svofski/fannyadams/kicad/synth.kicad_pcb

## KiCad design kicad/synth.kicad_pcb (2016-01-24)

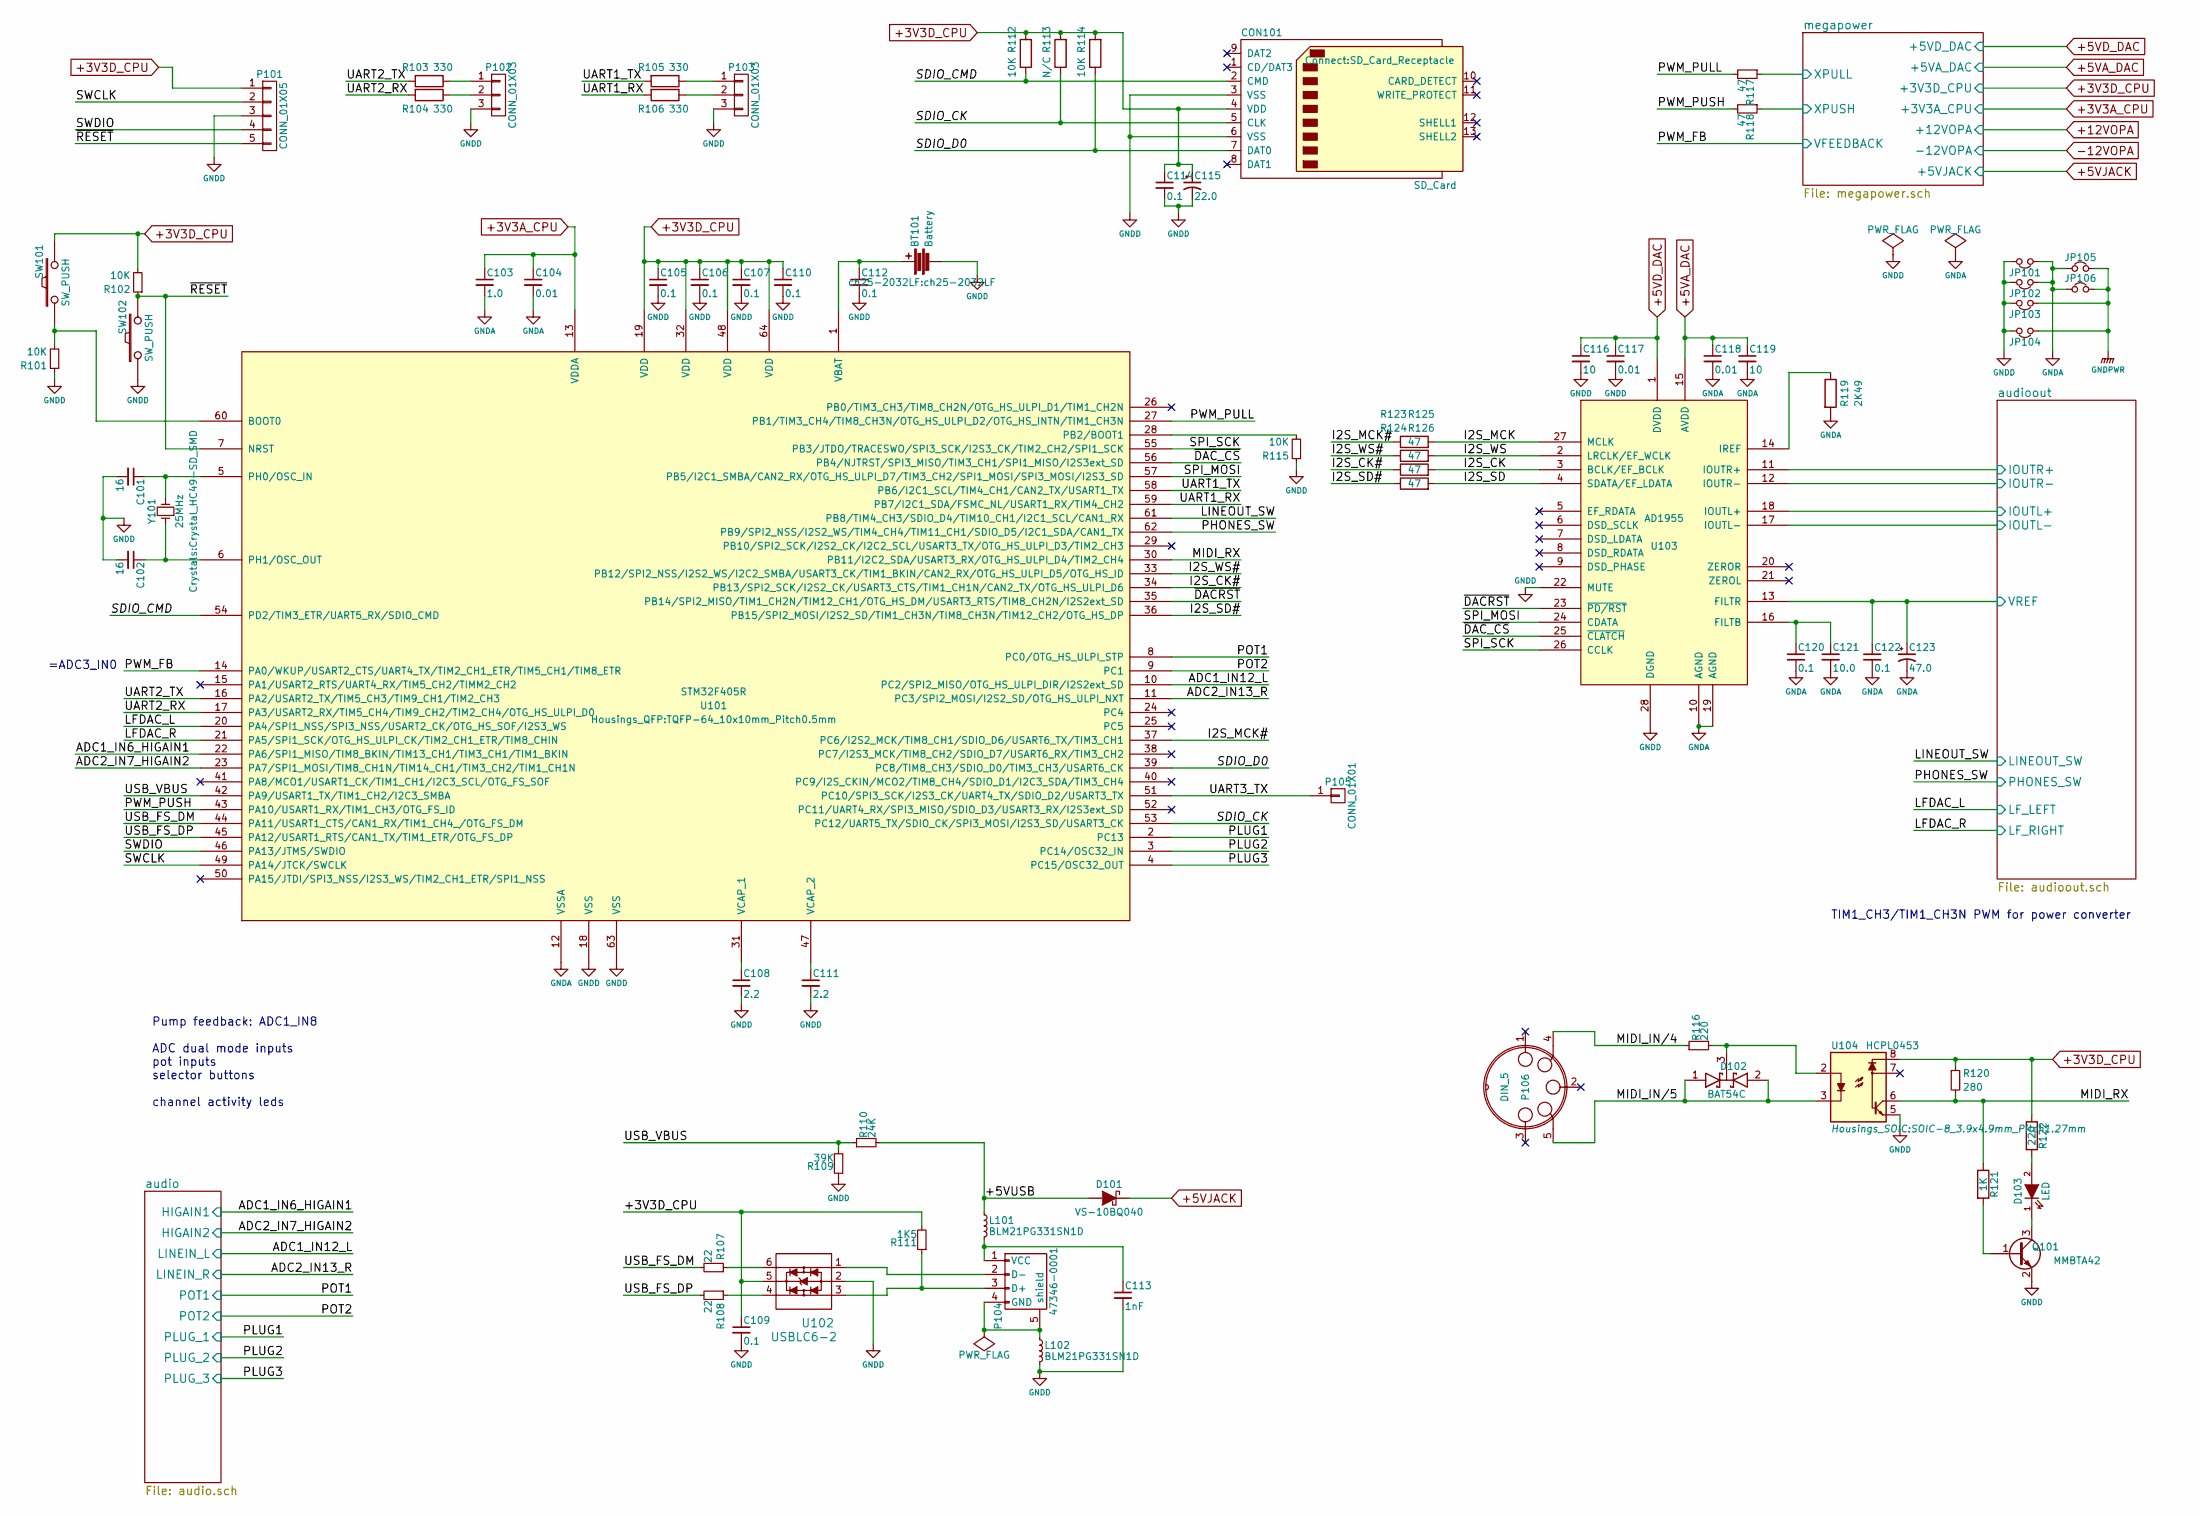
[picture p1: schematic synth.sch]

Parts:
BT101: Battery; ch25-2032LF
C101, C102: 16; C_0805
C103: 1.0; C_0805
C104, C117, C118: 0.01; C_0805
C105, C106, C107, C110, C112, C114, C120, C122: 0.1; C_0603
C108, C111: 2.2; C_0805
C109: 0.1; C_0805
C113: 1nF; C_0805
C115: 22.0; TantalC_SizeD_EIA-7343_Reflow
C116, C119: 10; C_0805
C121: 10.0; C_0805
C123: 47.0; c_elec_5x5.3
CON101: SD_Card; SD_Card_Receptacle
D101: VS-10BQ040; SMB_Standard
D102: BAT54C; SOT-23
D103: LED; LED-0805
JP101, JP102, JP103, JP104, JP105, JP106: Jumper_NC_Small; R_0603
L101, L102: BLM21PG331SN1D; R_0805
P101: CONN_01X05; Pin_Header_Straight_1x05
P102, P103: CONN_01X03; Pin_Header_Straight_1x03
P104: 47346-0001; USB_Micro-B
P105: CONN_01X01; 1Pin
P106: DIN_5; din-5
Q101: MMBTA42; SOT-23
R101, R102, R112, R114, R115: 10K; R_0805
R103, R104, R105, R106: 330; R_0805
R107, R108: 22; R_0805
R109: 39K; R_0805
R110: 24K; R_0805
R111: 1K5; R_0805
R113: N/C; R_0805
R116, R122: 220; R_0805
R117, R118, R123, R124, R125, R126: 47; R_0402
R119: 2K49; R_0805
R120: 280; R_0805
R121: 1K; R_0805
SW101, SW102: SW_PUSH; SW_PUSH_SMALL
U101: STM32F405R; TQFP-64_10x10mm_Pitch0.5mm
U102: USBLC6-2; SOT-23-6
U103: AD1955; SSOP-28_5.3x10.2mm_Pitch0.65mm
U104: HCPL0453; SOIC-8_3.9x4.9mm_Pitch1.27mm
Y101: 25MHz; Crystal_HC49-SD_SMD

Connections:
+3V3A_CPU: C103.1, C104.1, U101.13 (VDDA); also elsewhere on the board
+3V3D_CPU: C105.1, C106.1, C107.1, C109.1, C110.1, C114.1, C115.1, CON101.4 (VDD), P101.1, R102.2, R111.2, R112.2, R113.2, R114.2, R120.1, R122.1, SW101.2, U101.19 (VDD), U101.32 (VDD), U101.48 (VDD), U101.64 (VDD), U102.5, U104.8; also elsewhere on the board
+5VA_DAC: C118.1, C119.1, U103.15 (AVDD); also elsewhere on the board
+5VD_DAC: C116.1, C117.1, U103.1 (DVDD); also elsewhere on the board
+5VJACK: D101.1 (K); also elsewhere on the board
/+5VUSB: D101.2 (A), L101.1, R110.2
/I2S_CK: R125.2, U103.3 (BCLK/EF_BCLK)
/I2S_CK#: R125.1, U101.34 (PB13/SPI2_SCK/I2S2_CK/USART3_CTS/TIM1_C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)
/I2S_MCK: R123.2, U103.27 (MCLK)
/I2S_MCK#: R123.1, U101.37 (PC6/I2S2_MCK/TIM8_CH1/SDIO_D6/USART6_TX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)
/I2S_SD: R126.2, U103.4 (SDATA/EF_LDATA)
/I2S_SD#: R126.1, U101.36 (PB15/SPI2_MOSI/I2S2_SD/TIM1_CH3N/TIM8_C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)
/I2S_WS: R124.2, U103.2 (LRCLK/EF_WCLK)
/I2S_WS#: R124.1, U101.33 (PB12/SPI2_NSS/I2S2_WS/I2C2_SMBA/USART3_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)
/MIDI_IN/4: P106.4, R116.1
/MIDI_IN/5: D102.1 (A), D102.2 (A), P106.5, U104.3
/MIDI_RX: R120.2, R121.1, U101.30 (PB11/I2C2_SDA/USART3_RX/OTG_HS_ULPI_D4/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), U104.6
/PWM_PULL: R117.2, U101.27 (PB1/TIM3_CH4/TIM8_CH3N/OTG_HS_ULPI_D2/O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)
/PWM_PUSH: R118.2, U101.43 (PA10/USART1_RX/TIM1_CH3/OTG_FS_ID)
/SDIO_CK: CON101.5 (CLK), R113.1, U101.53 (PC12/UART5_TX/SDIO_CK/SPI3_MOSI/I2S3_SD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)
/SDIO_CMD: CON101.2 (CMD), R112.1, U101.54 (PD2/TIM3_ETR/UART5_RX/SDIO_CMD)
/SDIO_D0: CON101.7 (DAT0), R114.1, U101.39 (PC8/TIM8_CH3/SDIO_D0/TIM3_CH3/USART6_CK)
/SPI_MOSI: U101.57 (PB5/I2C1_SMBA/CAN2_RX/OTG_HS_ULPI_D7/TI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), U103.24 (CDATA)
/SPI_SCK: U101.55 (PB3/JTDO/TRACESWO/SPI3_SCK/I2S3_CK/TIM2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), U103.26 (CCLK)
/SWCLK: P101.2, U101.49 (PA14/JTCK/SWCLK)
/SWDIO: P101.4, U101.46 (PA13/JTMS/SWDIO)
/UART1_RX: R106.2, U101.59 (PB7/I2C1_SDA/FSMC_NL/USART1_RX/TIM4_CH2)
/UART1_TX: R105.2, U101.58 (PB6/I2C1_SCL/TIM4_CH1/CAN2_TX/USART1_TX)
/UART2_RX: R104.2, U101.17 (PA3/USART2_RX/TIM5_CH4/TIM9_CH2/TIM2_CH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)
/UART2_TX: R103.2, U101.16 (PA2/USART2_TX/TIM5_CH3/TIM9_CH1/TIM2_CH3)
/UART3_TX: P105.1, U101.51 (PC10/SPI3_SCK/I2S3_CK/UART4_TX/SDIO_D2/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)
/USB_FS_DM: R107.2, U101.44 (PA11/USART1_CTS/CAN1_RX/TIM1_CH4_/OTG_F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)
/USB_FS_DP: R108.2, U101.45 (PA12/USART1_RTS/CAN1_TX/TIM1_ETR/OTG_FS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)
/USB_VBUS: R109.2, R110.1, U101.42 (PA9/USART1_TX/TIM1_CH2/I2C3_SMBA)
/audio/HIGAIN1: U101.22 (PA6/SPI1_MISO/TIM8_BKIN/TIM13_CH1/TIM3_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); also elsewhere on the board
/audio/HIGAIN2: U101.23 (PA7/SPI1_MOSI/TIM8_CH1N/TIM14_CH1/TIM3_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); also elsewhere on the board
/audio/LINEIN_L: U101.10 (PC2/SPI2_MISO/OTG_HS_ULPI_DIR/I2S2ext_SD); also elsewhere on the board
/audio/LINEIN_R: U101.11 (PC3/SPI2_MOSI/I2S2_SD/OTG_HS_ULPI_NXT); also elsewhere on the board
/audio/PLUG_1: U101.2 (PC13); also elsewhere on the board
/audio/PLUG_2: U101.3 (PC14/OSC32_IN); also elsewhere on the board
/audio/PLUG_3: U101.4 (PC15/OSC32_OUT); also elsewhere on the board
/audio/POT1: U101.8 (PC0/OTG_HS_ULPI_STP); also elsewhere on the board
/audio/POT2: U101.9 (PC1); also elsewhere on the board
/audioout/IOUTL+: U103.18 (IOUTL+); also elsewhere on the board
/audioout/IOUTL-: U103.17 (IOUTL-); also elsewhere on the board
/audioout/IOUTR+: U103.11 (IOUTR+); also elsewhere on the board
/audioout/IOUTR-: U103.12 (IOUTR-); also elsewhere on the board
/audioout/LF_LEFT: U101.20 (PA4/SPI1_NSS/SPI3_NSS/USART2_CK/OTG_HS_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); also elsewhere on the board
/audioout/LF_RIGHT: U101.21 (PA5/SPI1_SCK/OTG_HS_ULPI_CK/TIM2_CH1_ET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); also elsewhere on the board
/audioout/LINEOUT_SW: U101.61 (PB8/TIM4_CH3/SDIO_D4/TIM10_CH1/I2C1_SCL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); also elsewhere on the board
/audioout/PHONES_SW: U101.62 (PB9/SPI2_NSS/I2S2_WS/TIM4_CH4/TIM11_CH1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); also elsewhere on the board
/audioout/VREF: C122.1, C123.1, U103.13 (FILTR); also elsewhere on the board
/megapower/VFEEDBACK: U101.14 (PA0/WKUP/USART2_CTS/UART4_TX/TIM2_CH1_E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); also elsewhere on the board
/megapower/XPULL: R117.1; also elsewhere on the board
/megapower/XPUSH: R118.1; also elsewhere on the board
/~DACRST: U101.35 (PB14/SPI2_MISO/TIM1_CH2N/TIM12_CH1/OTG_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), U103.23 (~PD/RST)
/~DAC_CS: U101.56 (PB4/NJTRST/SPI3_MISO/TIM3_CH1/SPI1_MISO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), U103.25 (~CLATCH)
/~RESET: P101.5, R102.1, SW102.2, U101.7 (NRST)
GNDA: C103.2, C104.2, C118.2, C119.2, C120.2, C121.2, C122.2, C123.2, JP101.1, JP102.1, JP105.1, JP106.1, R119.2, U101.12 (VSSA), U103.10 (AGND), U103.19 (AGND); also elsewhere on the board
GNDD: BT101.2, C101.2, C102.2, C105.2, C106.2, C107.2, C108.2, C109.2, C110.2, C111.2, C112.2, C113.2, C114.2, C115.2, C116.2, C117.2, CON101.3 (VSS), CON101.6 (VSS), JP101.2, JP102.2, JP103.2, JP104.2, L102.2, P101.3, P102.3, P103.3, Q101.2 (E), R101.1, R109.1, R115.1, SW102.1, U101.18 (VSS), U101.63 (VSS), U102.2, U103.22 (MUTE), U103.28 (DGND), U104.5; also elsewhere on the board
GNDPWR: JP103.1, JP104.1, JP105.2, JP106.2; also elsewhere on the board
unnamed: BT101.1, C112.1, U101.1 (VBAT)
unnamed: C101.1, U101.5 (PH0/OSC_IN), Y101.2
unnamed: C102.1, U101.6 (PH1/OSC_OUT), Y101.1
unnamed: C108.1, U101.31 (VCAP_1)
unnamed: C111.1, U101.47 (VCAP_2)
unnamed: C113.1, L101.2, P104.1 (VCC)
unnamed: C120.1, C121.1, U103.16 (FILTB)
unnamed: D102.3 (K), R116.2, U104.2
unnamed: D103.1 (K), Q101.3 (C)
unnamed: D103.2 (A), R122.2
unnamed: L102.1, P104.4 (GND), P104.5 (shield)
unnamed: P102.1, R103.1
unnamed: P102.2, R104.1
unnamed: P103.1, R105.1
unnamed: P103.2, R106.1
unnamed: P104.2 (D-), U102.1
unnamed: P104.3 (D+), R111.1, U102.3
unnamed: Q101.1 (B), R121.2
unnamed: R101.2, SW101.1, U101.60 (BOOT0)
unnamed: R107.1, U102.6
unnamed: R108.1, U102.4
unnamed: R115.2, U101.28 (PB2/BOOT1)
unnamed: R119.1, U103.14 (IREF)

Notes on the sheet:
TIM1_CH3/TIM1_CH3N PWM for power converter
Pump feedback: ADC1_IN8 ADC dual mode inputs pot inputs selector buttons channel activity leds
=ADC3_IN0

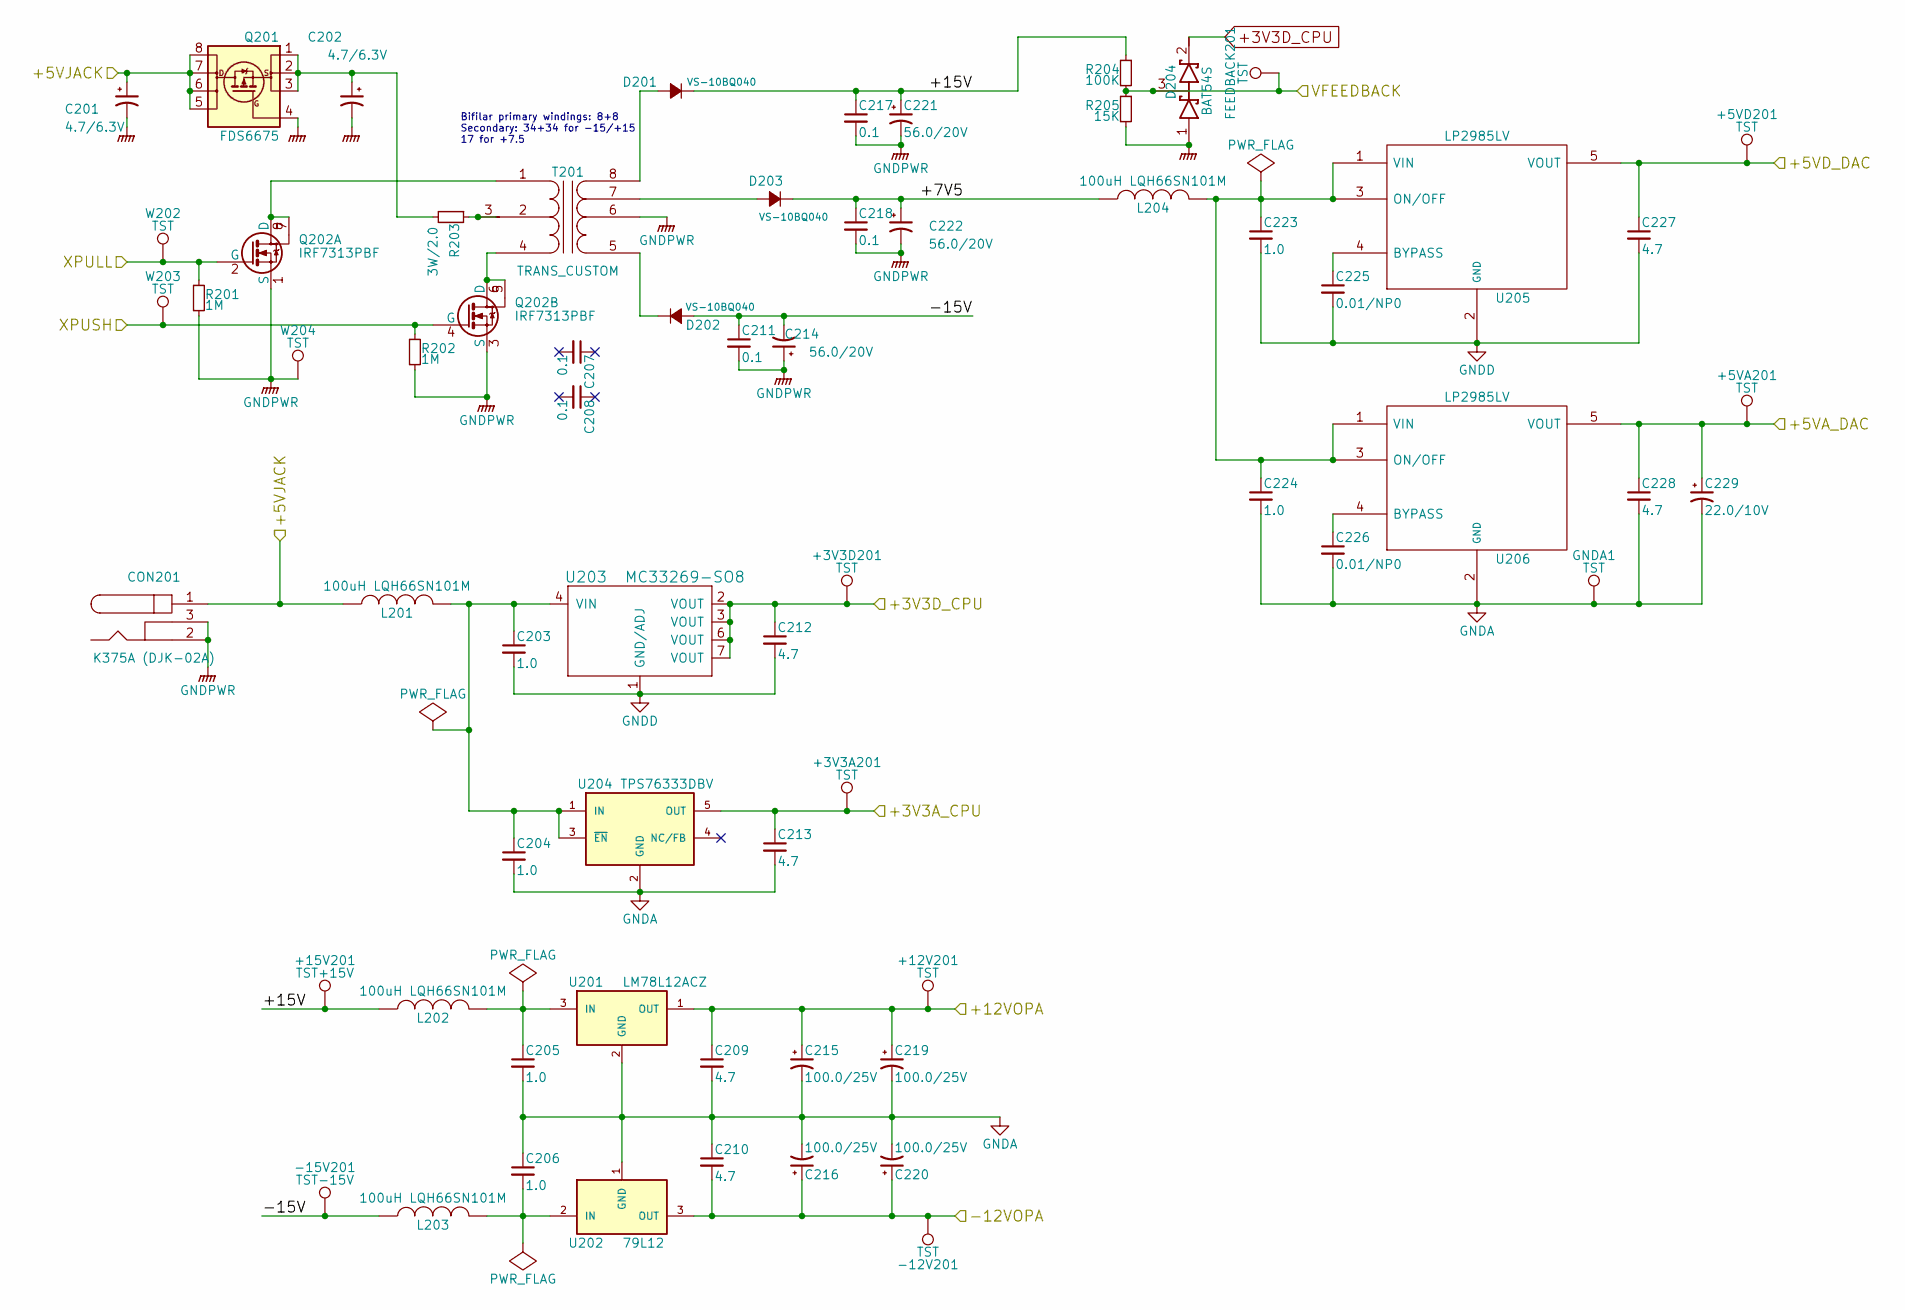
[picture p2: schematic megapower.sch]

Parts:
+3V3A201, +3V3D201, +5VA201, +5VD201, +12V201: TST; PINTST
+15V201: TST+15V; PINTST
-12V201: TST; PINTST
-15V201: TST-15V; PINTST
C201, C202: 4.7/6.3V; c_elec_5x5.3
C203, C204, C205, C206, C223, C224: 1.0; C_0805
C207, C208, C211: 0.1; C_0805
C209, C210, C212, C213, C227, C228: 4.7; C_0805
C214, C221, C222: 56.0/20V; C_Radial_D6.3_L11.2_P2.5
C215, C216, C219, C220: 100.0/25V; c_elec_6.3x7.7
C217, C218: 0.1; C_0603
C225, C226: 0.01/NP0; C_0805
C229: 22.0/10V; TantalC_SizeC_EIA-6032_Reflow
CON201: K375A (DJK-02A); BARREL_JACK
D201, D202, D203: VS-10BQ040; SMB_Standard
D204: BAT54S; SOT-23
FEEDBACK201: TST; PINTST
GNDA1: TST; PINTST
L201, L202, L203, L204: 100uH LQH66SN101M; Choke_SMD_6.3x6.3_H3
Q201: FDS6675; SOIC-8_3.9x4.9mm_Pitch1.27mm
Q202: IRF7313PBF; SO-8
R201, R202: 1M; R_0805
R203: 3W/2.0; R_0805
R204: 100K; R_0805
R205: 15K; R_0805
T201: TRANS_CUSTOM; Coilcraft-Q4434-B_Rhombus-T1311
U201: LM78L12ACZ; TO-92_Inline_Wide
U202: 79L12; TO-92_Inline_Wide
U203: MC33269-SO8; SOIC-8_3.9x4.9mm_Pitch1.27mm
U204: TPS76333DBV; SOT-23-5
U205, U206: LP2985LV; SOT-23-5
W202, W203, W204: TST; PINTST

Connections:
+3V3A_CPU: +3V3A201.1, C213.1, U204.5 (OUT); also elsewhere on the board
+3V3D_CPU: +3V3D201.1, C212.1, D204.2 (K), U203.2 (VOUT), U203.3 (VOUT), U203.6 (VOUT), U203.7 (VOUT); also elsewhere on the board
+5VA_DAC: +5VA201.1, C228.1, C229.1, U206.5 (VOUT); also elsewhere on the board
+5VD_DAC: +5VD201.1, C227.1, U205.5 (VOUT); also elsewhere on the board
+5VJACK: C201.1, CON201.1, L201.1, Q201.5 (D), Q201.6 (D), Q201.7 (D), Q201.8 (D); also elsewhere on the board
+12VOPA: +12V201.1, C209.1, C215.1, C219.1, U201.1 (OUT); also elsewhere on the board
-12VOPA: -12V201.1, C210.2, C216.1, C220.1, U202.3 (OUT); also elsewhere on the board
/megapower/+7V5: C218.1, C222.1, D203.1 (K), L204.1
/megapower/+15V: +15V201.1, C217.1, C221.1, D201.1 (K), L202.1, R204.1
/megapower/-15V: -15V201.1, C211.1, C214.2, D202.2 (A), L203.1
/megapower/VFEEDBACK: D204.3 (common), FEEDBACK201.1, R204.2, R205.1; also elsewhere on the board
/megapower/XPULL: Q202.2 (G), R201.1, W202.1; also elsewhere on the board
/megapower/XPUSH: Q202.4 (G), R202.1, W203.1; also elsewhere on the board
GNDA: C204.2, C205.2, C206.1, C209.2, C210.1, C213.2, C215.2, C216.2, C219.2, C220.2, C224.2, C226.2, C228.2, C229.2, GNDA1.1, U201.2 (GND), U202.1 (GND), U204.2 (GND), U206.2 (GND); also elsewhere on the board
GNDD: C203.2, C212.2, C223.2, C225.2, C227.2, U203.1 (GND/ADJ), U205.2 (GND); also elsewhere on the board
GNDPWR: C201.2, C202.2, C211.2, C214.1, C217.2, C218.2, C221.2, C222.2, CON201.2, CON201.3, D204.1 (A), Q201.4 (G), Q202.1 (S), Q202.3 (S), R201.2, R202.2, R205.2, T201.6, W204.1; also elsewhere on the board
unnamed: C202.1, Q201.1 (S), Q201.2 (S), Q201.3 (S), R203.2
unnamed: C203.1, C204.1, L201.2, U203.4 (VIN), U204.1 (IN), U204.3 (~EN~)
unnamed: C205.1, L202.2, U201.3 (IN)
unnamed: C206.2, L203.2, U202.2 (IN)
unnamed: C223.1, C224.1, L204.2, U205.1 (VIN), U205.3 (ON/OFF), U206.1 (VIN), U206.3 (ON/OFF)
unnamed: C225.1, U205.4 (BYPASS)
unnamed: C226.1, U206.4 (BYPASS)
unnamed: D201.2 (A), T201.8 (S2)
unnamed: D202.1 (K), T201.5 (S1)
unnamed: D203.2 (A), T201.7
unnamed: Q202.5, Q202.6 (D), T201.4 (PR2)
unnamed: Q202.7, Q202.8 (D), T201.1 (PR1)
unnamed: R203.1, T201.2 (PM), T201.3

Notes on the sheet:
Bifilar primary windings: 8+8 Secondary: 34+34 for -15/+15 17 for +7.5

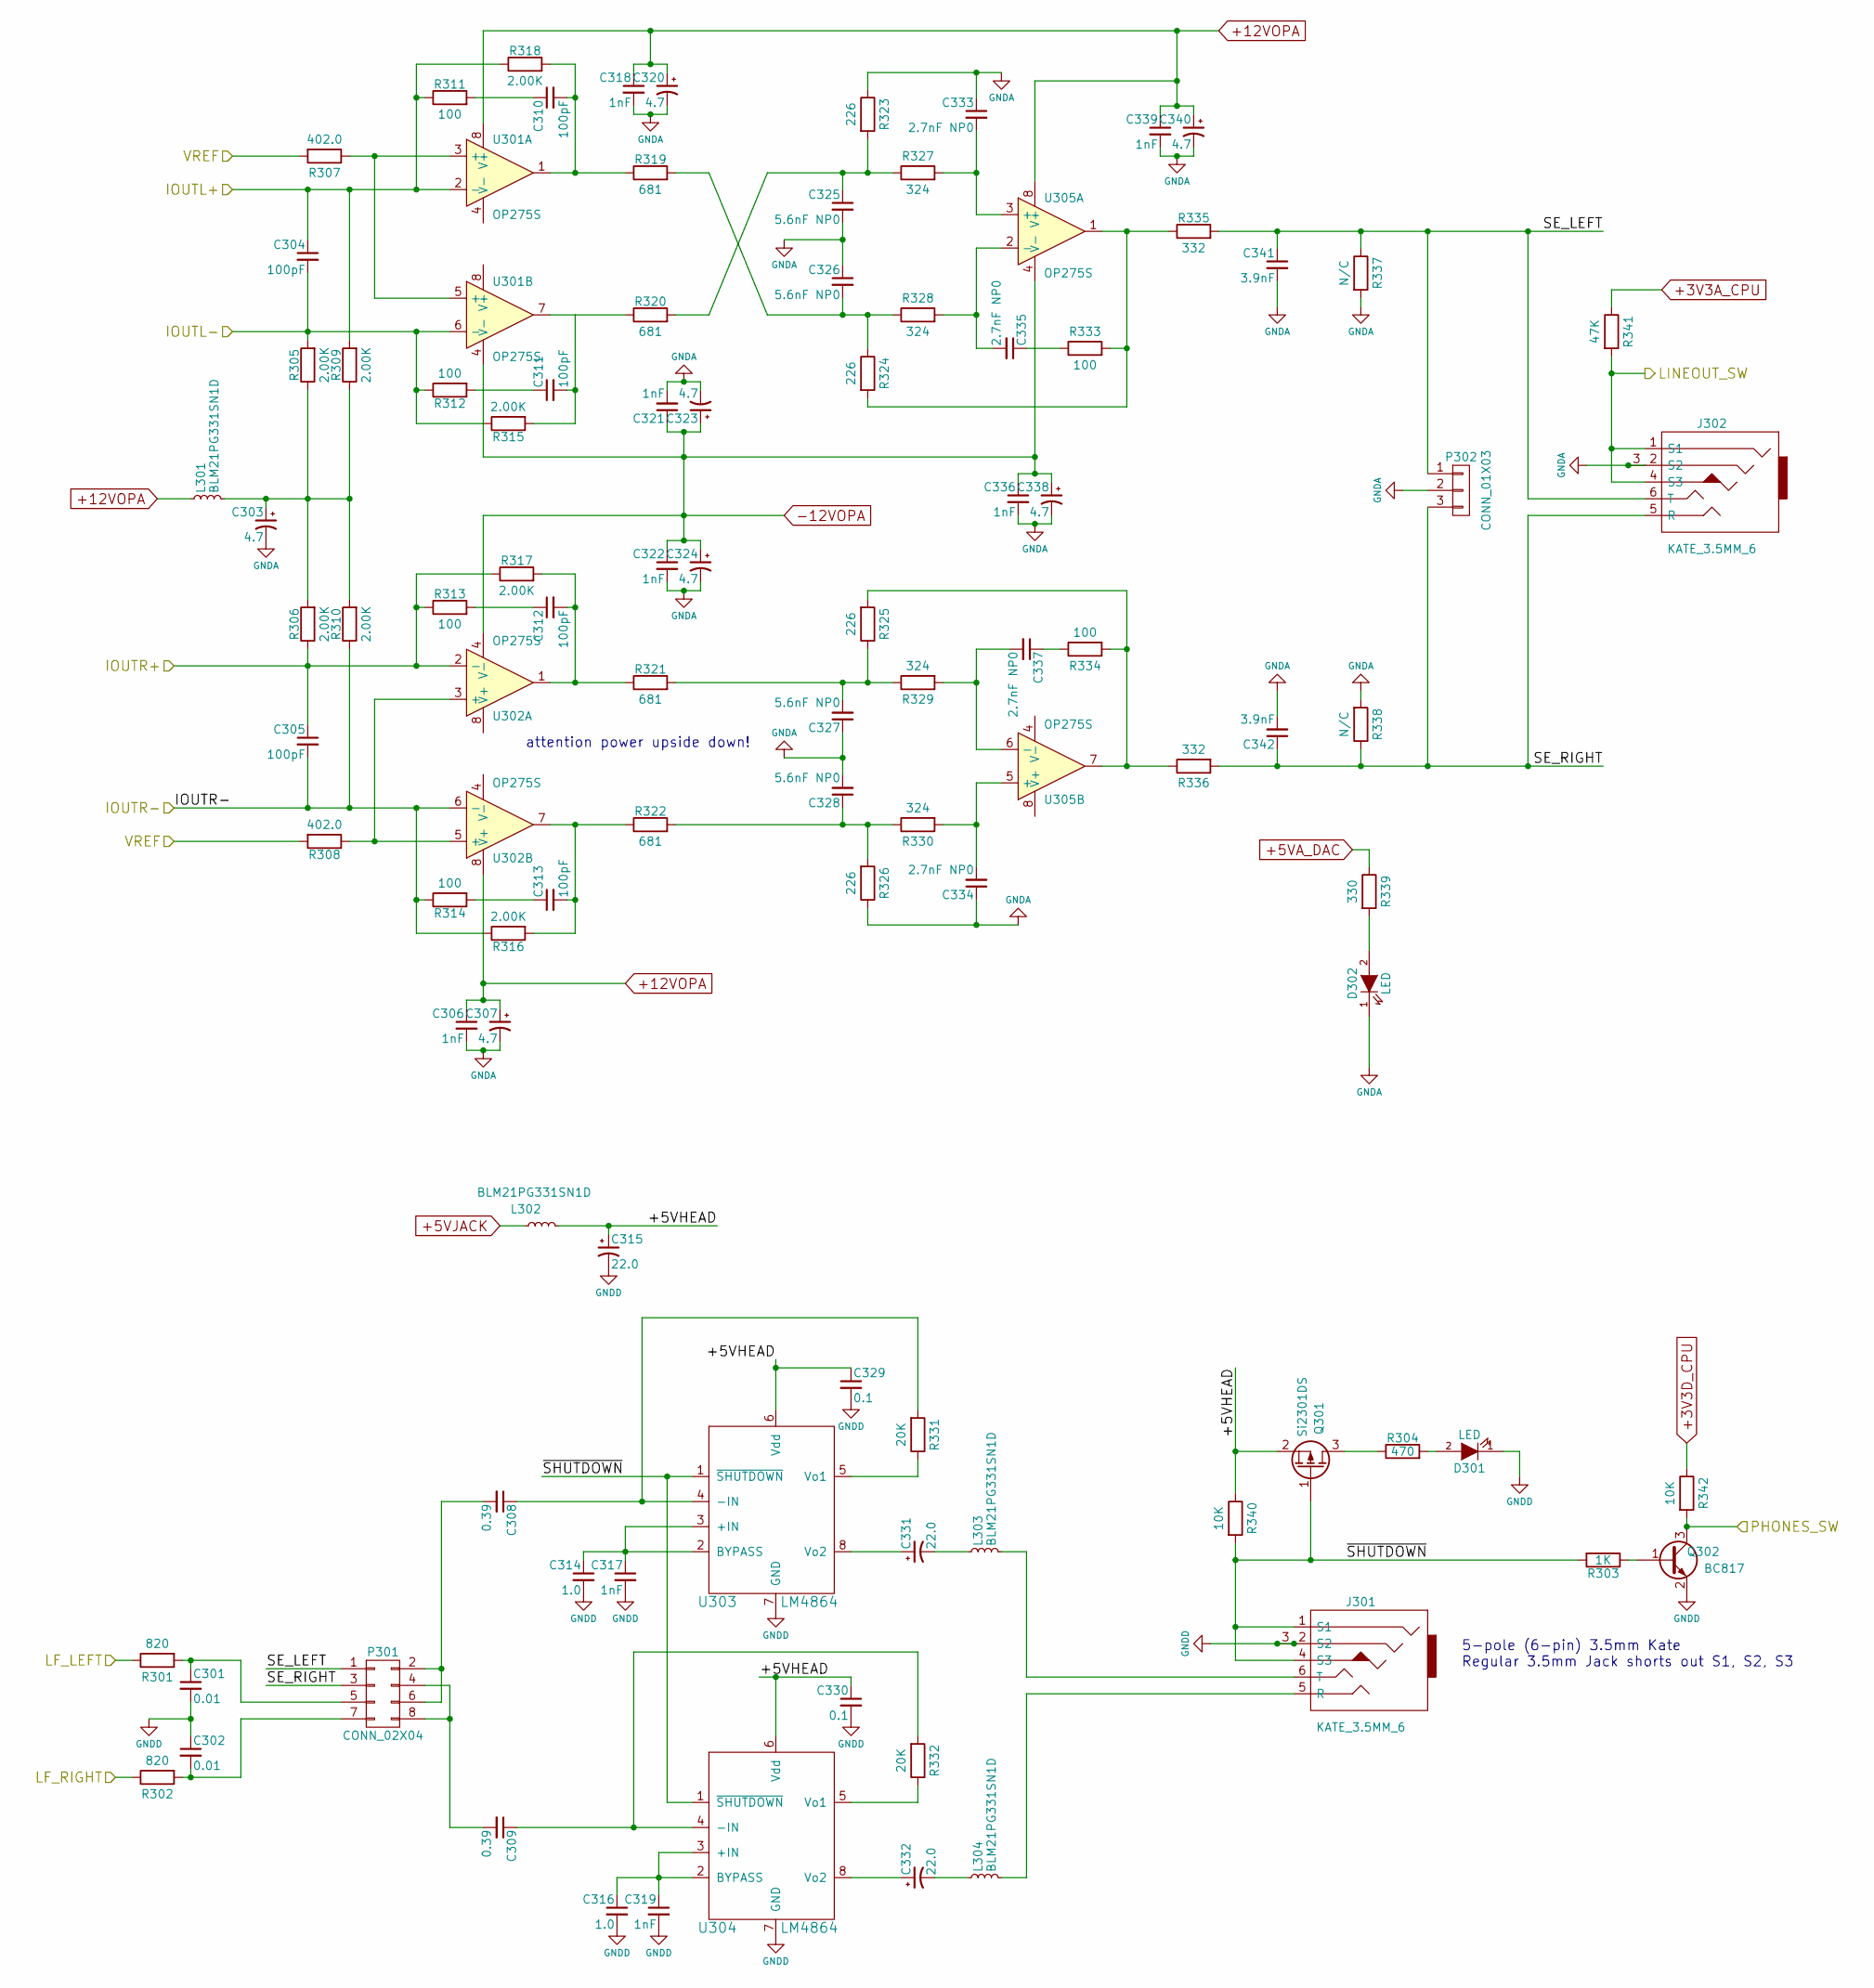
[picture p3: schematic audioout.sch]

Parts:
C301, C302: 0.01; C_0805
C303, C307, C320, C323, C324, C338, C340: 4.7; C_0805
C304, C305, C310, C311, C312, C313: 100pF; C_0805
C306, C317, C318, C319, C321, C322, C336, C339: 1nF; C_0805
C308, C309: 0.39; C_0805
C314, C316: 1.0; C_0805
C315, C331, C332: 22.0; TantalC_SizeC_EIA-6032_Reflow
C325, C326, C327, C328: 5.6nF NP0; C_0805
C329, C330: 0.1; C_0805
C333, C334, C335, C337: 2.7nF NP0; C_0805
C341, C342: 3.9nF; C_0805
D301, D302: LED; LED-0805
J301, J302: KATE_3.5MM_6; JACK_35MM_KATE_6
L301, L302, L303, L304: BLM21PG331SN1D; R_0805
P301: CONN_02X04; Pin_Header_Straight_2x04
P302: CONN_01X03; Pin_Header_Straight_1x03
Q301: Si2301DS; SOT-23
Q302: BC817; SOT-23
R301, R302: 820; R_1206
R303: 1K; R_0805
R304: 470; R_0805
R305, R306, R309, R310, R315, R316, R317, R318: 2.00K; R_0805
R307, R308: 402.0; R_1206
R311, R312, R313, R314, R333, R334: 100; R_0805
R319, R320, R321, R322: 681; R_0805
R323, R324, R325, R326: 226; R_0805
R327, R328, R329, R330: 324; R_0805
R331, R332: 20K; R_0805
R335, R336: 332; R_0805
R337, R338: N/C; R_0805
R339: 330; R_0805
R340, R342: 10K; R_0805
R341: 47K; R_0805
U301, U302, U305: OP275S; SOIC-8_3.9x4.9mm_Pitch1.27mm
U303, U304: LM4864; SOIC-8_3.9x4.9mm_Pitch1.27mm

Connections:
+3V3A_CPU: R341.1; also elsewhere on the board
+3V3D_CPU: R342.1; also elsewhere on the board
+5VA_DAC: R339.1; also elsewhere on the board
+5VJACK: L302.1; also elsewhere on the board
+12VOPA: C306.1, C307.1, C318.1, C320.1, C339.1, C340.1, L301.1, U301.8 (V+), U302.8 (V+), U305.8 (V+); also elsewhere on the board
-12VOPA: C321.1, C322.1, C323.1, C324.1, C336.1, C338.1, U301.4 (V-), U302.4 (V-), U305.4 (V-); also elsewhere on the board
/audioout/+5VHEAD: C315.1, C329.1, C330.1, L302.2, Q301.2 (S), R340.1, U303.6 (Vdd), U304.6 (Vdd)
/audioout/IOUTL+: C304.1, R309.2, R311.1, R318.1, U301.2 (-); also elsewhere on the board
/audioout/IOUTL-: C304.2, R305.2, R312.1, R315.1, U301.6 (-); also elsewhere on the board
/audioout/IOUTR+: C305.1, R306.1, R313.1, R317.1, U302.2 (-); also elsewhere on the board
/audioout/IOUTR-: C305.2, R310.1, R314.1, R316.1, U302.6 (-); also elsewhere on the board
/audioout/LF_LEFT: R301.1; also elsewhere on the board
/audioout/LF_RIGHT: R302.1; also elsewhere on the board
/audioout/LINEOUT_SW: J302.1 (S1), J302.4 (S3), R341.2; also elsewhere on the board
/audioout/PHONES_SW: Q302.3 (C), R342.2; also elsewhere on the board
/audioout/SE_LEFT: C341.1, J302.6 (T), P301.1, P302.1, R335.2, R337.1
/audioout/SE_RIGHT: C342.1, J302.5 (R), P301.3, P302.3, R336.2, R338.1
/audioout/VREF: R307.2, R308.2; also elsewhere on the board
/audioout/~SHUTDOWN: J301.1 (S1), J301.4 (S3), Q301.1 (G), R303.2, R340.2, U303.1 (~SHUTDOWN), U304.1 (~SHUTDOWN)
GNDA: C303.2, C306.2, C307.2, C318.2, C320.2, C321.2, C322.2, C323.2, C324.2, C325.2, C326.1, C327.1, C328.2, C333.1, C334.1, C336.2, C338.2, C339.2, C340.2, C341.2, C342.2, D302.1 (K), J302.2 (S2), J302.3, P302.2, R323.1, R326.1, R337.2, R338.2; also elsewhere on the board
GNDD: C301.2, C302.1, C314.2, C315.2, C316.2, C317.2, C319.2, C329.2, C330.2, D301.1 (K), J301.2 (S2), J301.3, Q302.2 (E), U303.7 (GND), U304.7 (GND); also elsewhere on the board
unnamed: C301.1, P301.5, R301.2
unnamed: C302.2, P301.7, R302.2
unnamed: C303.1, L301.2, R305.1, R306.2, R309.1, R310.2
unnamed: C308.2, P301.2, P301.6
unnamed: C309.2, P301.4, P301.8
unnamed: C310.1, R311.2
unnamed: C310.2, R318.2, R319.1, U301.1
unnamed: C311.1, R312.2
unnamed: C312.1, R313.2
unnamed: C312.2, R317.2, R321.1, U302.1
unnamed: C313.1, R314.2
unnamed: C313.2, R316.2, R322.1, U302.7
unnamed: C314.1, C317.1, U303.2 (BYPASS), U303.3 (+IN)
unnamed: C316.1, C319.1, U304.2 (BYPASS), U304.3 (+IN)
unnamed: C325.1, R320.2, R323.2, R327.1
unnamed: C326.2, R319.2, R324.1, R328.1
unnamed: C327.2, R321.2, R325.1, R329.1
unnamed: C328.1, R322.2, R326.2, R330.1
unnamed: C331.1, U303.8 (Vo2)
unnamed: C331.2, L303.1
unnamed: C332.1, U304.8 (Vo2)
unnamed: C332.2, L304.1
unnamed: C333.2, R327.2, U305.3 (+)
unnamed: C334.2, R330.2, U305.5 (+)
unnamed: C335.1, R333.1
unnamed: C335.2, R328.2, U305.2 (-)
unnamed: C337.1, R334.1
unnamed: C337.2, R329.2, U305.6 (-)
unnamed: D301.2 (A), R304.2
unnamed: D302.2 (A), R339.2
unnamed: J301.5 (R), L304.2
unnamed: J301.6 (T), L303.2
unnamed: Q301.3 (D), R304.1
unnamed: Q302.1 (B), R303.1
unnamed: R307.1, U301.3 (+), U301.5 (+)
unnamed: R308.1, U302.3 (+), U302.5 (+)
unnamed: R324.2, R333.2, R335.1, U305.1
unnamed: R325.2, R334.2, R336.1, U305.7
unnamed: R331.1, U303.5 (Vo1)
unnamed: R332.1, U304.5 (Vo1)

Notes on the sheet:
attention power upside down!
5-pole (6-pin) 3.5mm Kate Regular 3.5mm Jack shorts out S1, S2, S3
