svofski/fannyadams/kicad/synth.kicad_pcb

## KiCad design kicad/synth.kicad_pcb (continued)

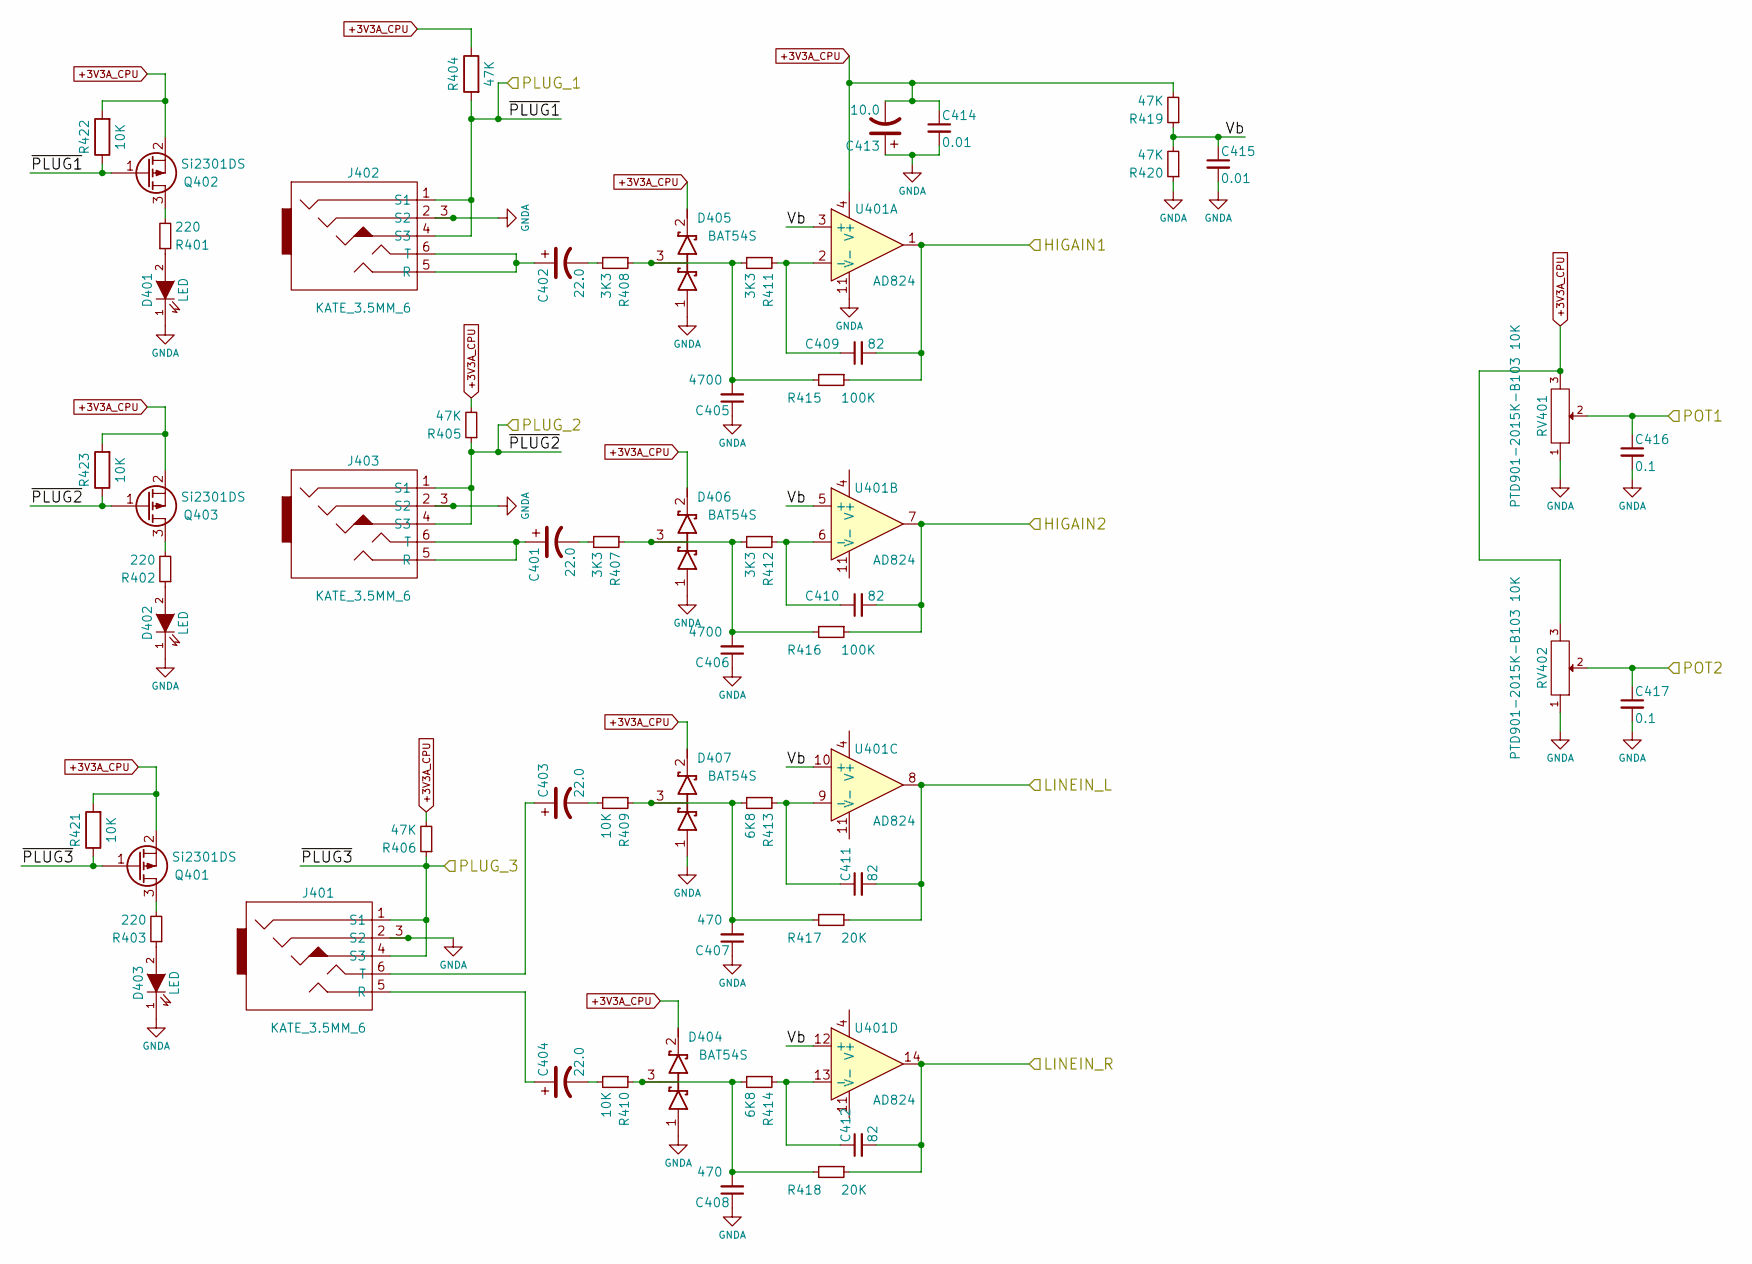
[picture p4: schematic audio.sch]

Parts:
C401, C402, C403, C404: 22.0; TantalC_SizeC_EIA-6032_Reflow
C405, C406: 4700; C_0805
C407, C408: 470; C_0805
C409, C410, C411, C412: 82; C_0805
C413: 10.0; C_0805
C414, C415: 0.01; C_0805
C416, C417: 0.1; C_0805
D401, D402, D403: LED; LED-0805
D404, D405, D406, D407: BAT54S; SOT-23
J401, J402, J403: KATE_3.5MM_6; JACK_35MM_KATE_6
Q401, Q402, Q403: Si2301DS; SOT-23
R401, R402, R403: 220; R_0805
R404, R405, R406, R419, R420: 47K; R_0805
R407, R408, R411, R412: 3K3; R_0805
R409, R410, R421, R422, R423: 10K; R_0805
R413, R414: 6K8; R_0805
R415, R416: 100K; R_0805
R417, R418: 20K; R_0805
RV401, RV402: PTD901-2015K-B103 10K; Potentiometer_Alps-RK16-single_largePads
U401: AD824; SOIC-14_3.9x8.7mm_Pitch1.27mm

Connections:
+3V3A_CPU: C413.2, C414.1, D404.2 (K), D405.2 (K), D406.2 (K), D407.2 (K), Q401.2 (S), Q402.2 (S), Q403.2 (S), R404.1, R405.2, R406.2, R419.2, R421.2, R422.2, R423.2, RV401.3, RV402.3, U401.4 (V+); also elsewhere on the board
/audio/HIGAIN1: C409.2, R415.1, U401.1; also elsewhere on the board
/audio/HIGAIN2: C410.2, R416.1, U401.7; also elsewhere on the board
/audio/LINEIN_L: C411.2, R417.1, U401.8; also elsewhere on the board
/audio/LINEIN_R: C412.2, R418.1, U401.14; also elsewhere on the board
/audio/PLUG_1: J402.1 (S1), J402.4 (S3), Q402.1 (G), R404.2, R422.1; also elsewhere on the board
/audio/PLUG_2: J403.1 (S1), J403.4 (S3), Q403.1 (G), R405.1, R423.1; also elsewhere on the board
/audio/PLUG_3: J401.1 (S1), J401.4 (S3), Q401.1 (G), R406.1, R421.1; also elsewhere on the board
/audio/POT1: C416.1, RV401.2; also elsewhere on the board
/audio/POT2: C417.1, RV402.2; also elsewhere on the board
/audio/Vb: C415.1, R419.1, R420.2, U401.3 (+), U401.5 (+), U401.10 (+), U401.12 (+)
GNDA: C405.1, C406.1, C407.1, C408.1, C413.1, C414.2, C415.2, C416.2, C417.2, D401.1 (K), D402.1 (K), D403.1 (K), D404.1 (A), D405.1 (A), D406.1 (A), D407.1 (A), J401.2 (S2), J401.3, J402.2 (S2), J402.3, J403.2 (S2), J403.3, R420.1, RV401.1, RV402.1, U401.11 (V-); also elsewhere on the board
unnamed: C401.1, J403.5 (R), J403.6 (T)
unnamed: C401.2, R407.2
unnamed: C402.1, J402.5 (R), J402.6 (T)
unnamed: C402.2, R408.2
unnamed: C403.1, J401.6 (T)
unnamed: C403.2, R409.2
unnamed: C404.1, J401.5 (R)
unnamed: C404.2, R410.2
unnamed: C405.2, D405.3 (common), R408.1, R411.2, R415.2
unnamed: C406.2, D406.3 (common), R407.1, R412.2, R416.2
unnamed: C407.2, D407.3 (common), R409.1, R413.2, R417.2
unnamed: C408.2, D404.3 (common), R410.1, R414.2, R418.2
unnamed: C409.1, R411.1, U401.2 (-)
unnamed: C410.1, R412.1, U401.6 (-)
unnamed: C411.1, R413.1, U401.9 (-)
unnamed: C412.1, R414.1, U401.13 (-)
unnamed: D401.2 (A), R401.1
unnamed: D402.2 (A), R402.1
unnamed: D403.2 (A), R403.1
unnamed: Q401.3 (D), R403.2
unnamed: Q402.3 (D), R401.2
unnamed: Q403.3 (D), R402.2

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
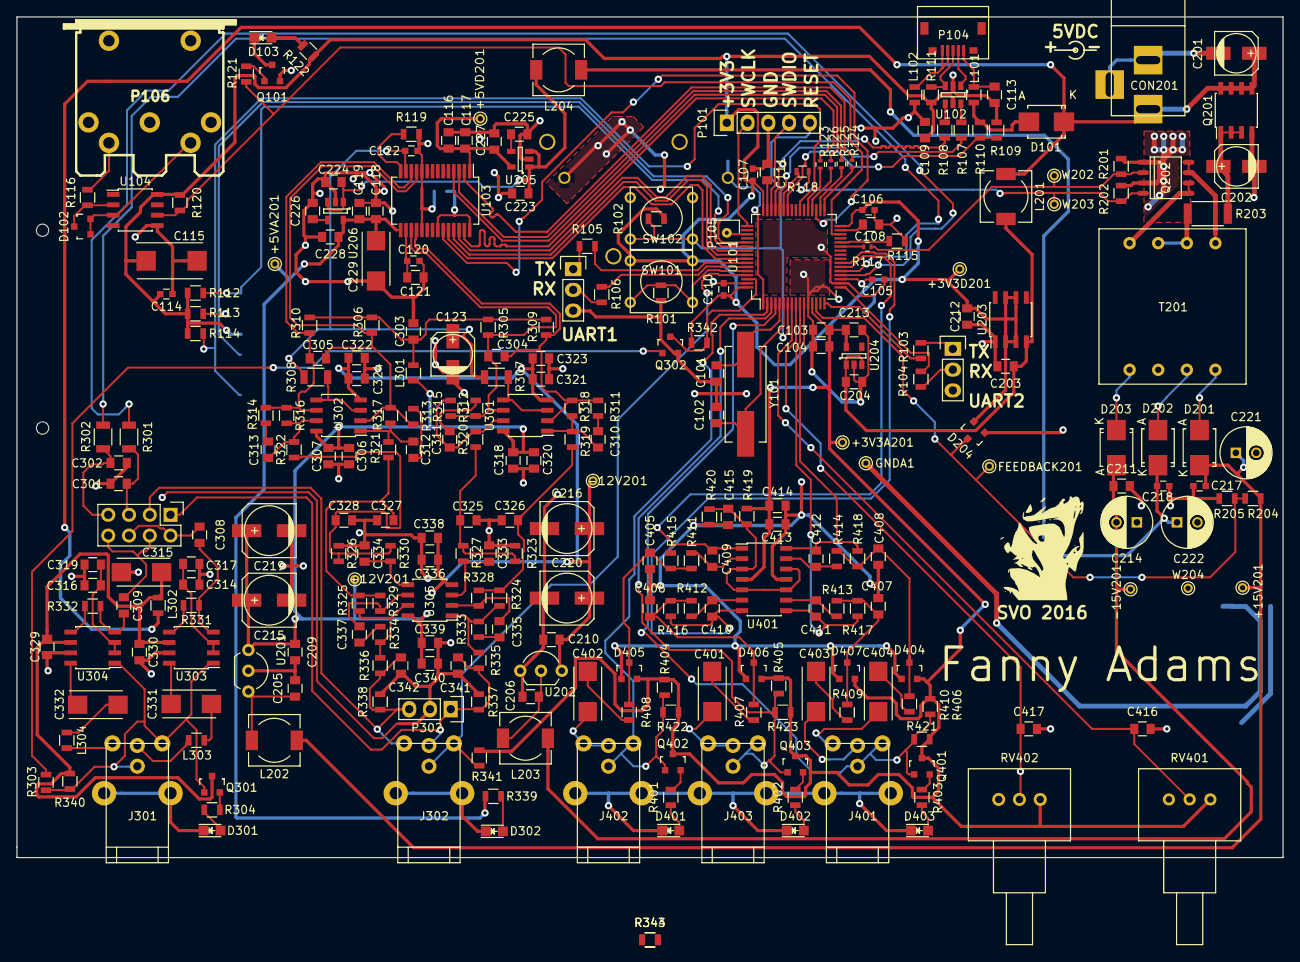
[picture p5: board synth.kicad_pcb from above]

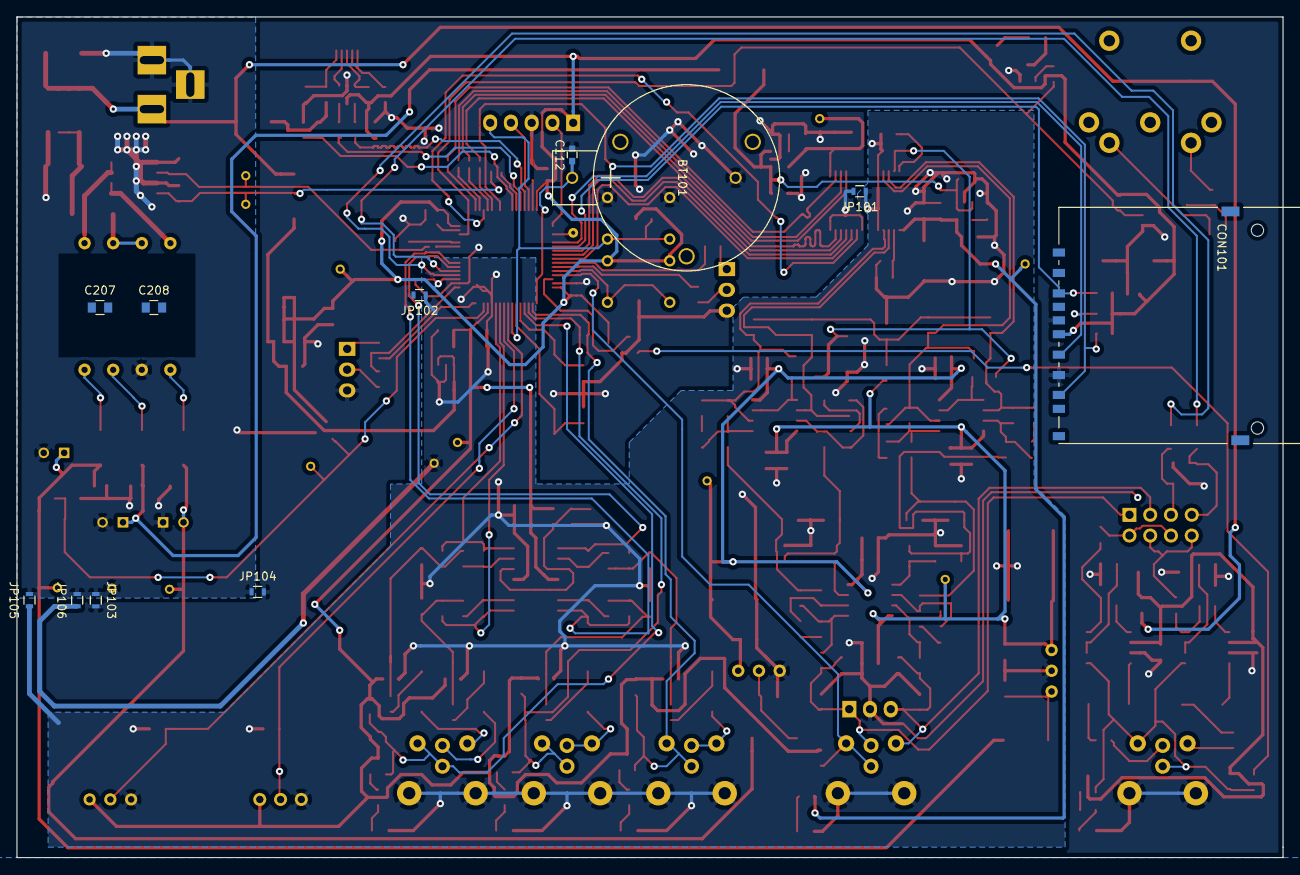
[picture p6: board synth.kicad_pcb from below]

Board: 2 copper layers, 154.9 x 102.9 mm, 300 parts (11 on the bottom side), 174 nets.

Other parts of the board:
R343, R344: 20K; R_0805
