svofski/fannyadams/src/fannyadams/mxconstants.h

/**
  ******************************************************************************
  * File Name          : mxconstants.h
  * Description        : This file contains the common defines of the application
  ******************************************************************************
  *
  * COPYRIGHT(c) 2015 STMicroelectronics
  *
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
  ******************************************************************************
  */
/* Includes ------------------------------------------------------------------*/


#define PLUG1_Pin GPIO_PIN_13
#define PLUG1_GPIO_Port GPIOC
#define PLUG2_Pin GPIO_PIN_14
#define PLUG2_GPIO_Port GPIOC
#define PLUG3_Pin GPIO_PIN_15
#define PLUG3_GPIO_Port GPIOC

#define ADC3_IN10_POT1_Pin GPIO_PIN_0
#define ADC3_IN10_POT1_GPIO_Port GPIOC
#define ADC3_IN11_POT2_Pin GPIO_PIN_1
#define ADC3_IN11_POT2_GPIO_Port GPIOC

#define ADC1_IN12_L_Pin GPIO_PIN_2
#define ADC1_IN12_L_GPIO_Port GPIOC
#define ADC2_IN13_R_Pin GPIO_PIN_3
#define ADC2_IN13_R_GPIO_Port GPIOC
#define ADC3_IN0_PWM_FB_Pin GPIO_PIN_0
#define ADC3_IN0_PWM_FB_GPIO_Port GPIOA
  
#define ADC1_IN6_HIGAIN1_Pin GPIO_PIN_6
#define ADC1_IN6_HIGAIN1_GPIO_Port GPIOA
#define ADC2_IN7_HIGAIN2_Pin GPIO_PIN_7
#define ADC2_IN7_HIGAIN2_GPIO_Port GPIOA
#define PWM_PULL_Pin GPIO_PIN_1
#define PWM_PULL_GPIO_Port GPIOB
#define USART3_RX_MIDI_IN_Pin GPIO_PIN_11
#define USART3_RX_MIDI_IN_GPIO_Port GPIOB
#define DACRST_Pin GPIO_PIN_14
#define DACRST_GPIO_Port GPIOB
#define PHONES_ENA_Pin GPIO_PIN_7
#define PHONES_ENA_GPIO_Port GPIOC
#define LEDPLUG2_Pin GPIO_PIN_9
#define LEDPLUG2_GPIO_Port GPIOC
#define LEDPLUG3_Pin GPIO_PIN_8
#define LEDPLUG3_GPIO_Port GPIOA
#define PWM_PUSH_Pin GPIO_PIN_10
#define PWM_PUSH_GPIO_Port GPIOA
#define LEDPLUG1_Pin GPIO_PIN_11
#define LEDPLUG1_GPIO_Port GPIOC
#define DAC_CS_Pin GPIO_PIN_4
#define DAC_CS_GPIO_Port GPIOB
#define LINEOUT_SW_Pin GPIO_PIN_8
#define LINEOUT_SW_GPIO_Port GPIOB
#define PHONES_SW_Pin GPIO_PIN_9
#define PHONES_SW_GPIO_Port GPIOB
/**
  * @}
  */ 

/**
  * @}
*/ 

/************************ (C) COPYRIGHT STMicroelectronics *****END OF FILE****/
