svofski/fannyadams/src/fannyadams/sintab.h

const float sintab[4096]={0.0,0.0015339801862847655,0.003067956762965976,0.0046019261204485705,0.006135884649154475,0.007669828739531097,0.00920375478205982,0.01073765916726449,0.012271538285719925,0.01380538852806039,0.0153392062849881,0.01687298794728171,0.01840672990580482,0.01994042855151444,0.021474080275469508,0.02300768146883937,0.024541228522912288,0.0260747178291039,0.02760814577896574,0.029141508764193722,0.030674803176636626,0.032208025408304586,0.03374117185137758,0.03527423889821395,0.03680722294135883,0.038340120373552694,0.03987292758773981,0.04140564097707674,0.04293825693494082,0.04447077185493867,0.04600318213091462,0.0475354841569593,0.049067674327418015,0.05059974903689928,0.052131704680283324,0.05366353765273052,0.055195244349689934,0.05672682116690775,0.05825826450043575,0.05978957074663987,0.06132073630220858,0.0628517575641614,0.06438263092985747,0.0659133527970038,0.06744391956366405,0.06897432762826675,0.07050457338961386,0.07203465324688933,0.07356456359966743,0.0750943008479213,0.07662386139203149,0.07815324163279423,0.07968243797143013,0.08121144680959244,0.08274026454937569,0.08426888759332407,0.0857973123444399,0.08732553520619206,0.0888535525825246,0.09038136087786498,0.09190895649713272,0.09343633584574779,0.09496349532963899,0.09649043135525259,0.0980171403295606,0.09954361866006932,0.10106986275482782,0.10259586902243628,0.10412163387205459,0.10564715371341062,0.10717242495680884,0.10869744401313872,0.11022220729388306,0.11174671121112659,0.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
#define sintab_mask 4095
#define FIX 20
