svofski/fannyadams/src/fannyadams/patch.c

#include <inttypes.h>

#include "osc.h"
#include "patch.h"

const patch_t bank_gm[128] =
{
    { WF_PWM,       127, 12, 3, 2, 3 }, /* 0: AcouGrandPiano */
    { WF_PWM,       64,  12, 3, 2, 3 }, /* 1: BrightAcouGrand */
    { WF_TRIANGLE,  127, 12, 3, 2, 3 }, /* 2: ElecGrandPiano */
    { WF_SIN,       127, 12, 10, 1,3 }, /* 3: Honky-Tonk Piano */
    { WF_TRIANGLE,  127, 9,  4, 9, 4 }, /* 4: Rhodes Piano */
    { WF_PWM,       127, 12, 3, 2, 3 }, /* 5: Chorused Piano */
    { WF_SAW,       127, 15, 4, 1, 8 }, /* 6: Harpsichord */
    { WF_TRIANGLE,  127, 9,  4, 1, 8 }, /* 7: Clavinet */
    { WF_TRIANGLE,  127, 9,  4, 7, 8 }, /* 8: Celesta */

    { WF_TRIANGLE,       127, 10, 3, 2, 3 }, /* X: Stub */
    { WF_TRIANGLE,       127, 10, 3, 2, 3 }, /* X: Stub */
    { WF_TRIANGLE,       127, 10, 3, 2, 3 }, /* X: Stub */
    { WF_TRIANGLE,       127, 10, 3, 2, 3 }, /* X: Stub */
    { WF_TRIANGLE,       127, 10, 3, 2, 3 }, /* X: Stub */
    { WF_TRIANGLE,       127, 10, 3, 2, 3 }, /* X: Stub */
    { WF_TRIANGLE,       127, 10, 3, 2, 3 }, /* X: Stub */
    { WF_TRIANGLE,       127, 10, 3, 2, 3 }, /* X: Stub */
    { WF_TRIANGLE,       127, 10, 3, 2, 3 }, /* X: Stub */
    { WF_TRIANGLE,       127, 10, 3, 2, 3 }, /* X: Stub */
    { WF_TRIANGLE,       127, 10, 3, 2, 3 }, /* X: Stub */
    { WF_TRIANGLE,       127, 10, 3, 2, 3 }, /* X: Stub */
    { WF_TRIANGLE,       127, 10, 3, 2, 3 }, /* X: Stub */
    { WF_TRIANGLE,       127, 10, 3, 2, 3 }, /* X: Stub */
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
    { WF_TRIANGLE,       127, 10, 3, 2, 3 }, /* X: Stub */
    { WF_TRIANGLE,       127, 10, 3, 2, 3 }, /* X: Stub */
    { WF_TRIANGLE,       127, 10, 3, 2, 3 }, /* X: Stub */
    { WF_TRIANGLE,       127, 10, 3, 2, 3 }, /* X: Stub */

};
