svofski/fannyadams/src/fannyadams/notefreq.c

#include <math.h>
#include "notefreq.h"

/** Thanks to this wonderful answer:
 * https://dsp.stackexchange.com/a/1650
 */
float notefreq(midi_note_t note, int16_t pitchbend)
{
    return 440.0f * powf(2.0f, (note - 69)/12.0f + (pitchbend-8192)/(4096.f*12.f));
}

#if 0
// from http://tonalsoft.com/pub/news/pitch-bend.aspx

static
const float _12edo[] = {
// Octave -5
/* 0	C	*/ 8.1757989156,
/* 1	C#/Db	*/ 8.6619572180,
/* 2	D	*/ 9.1770239974,
/* 3	D#/Eb	*/ 9.7227182413,
/* 4	E	*/ 10.3008611535,
/* 5	F	*/ 10.9133822323,
/* 6	F#/Gb	*/ 11.5623257097,
/* 7	G	*/ 12.2498573744,
/* 8	G#/Ab	*/ 12.9782717994,
/* 9	A	*/ 13.7500000000,
/* 10	A#/Bb	*/ 14.5676175474,
/* 11	B	*/ 15.4338531643,

//Octave -4

/* 12	C	*/ 16.3515978313,
/* 13	C#/Db	*/ 17.3239144361,
/* 14	D	*/ 18.3540479948,
/* 15	D#/Eb	*/ 19.4454364826,
/* 16	E	*/ 20.6017223071,
/* 17	F	*/ 21.8267644646,
/* 18	F#/Gb	*/ 23.1246514195,
/* 19	G	*/ 24.4997147489,
/* 20	G#/Ab	*/ 25.9565435987,
/* 21	A	*/ 27.5000000000,
/* 22	A#/Bb	*/ 29.1352350949,
/* 23	B	*/ 30.8677063285,

// octave -3

/* 24	C	*/ 32.7031956626,
/* 25	C#/Db	*/ 34.6478288721,
/* 26	D	*/ 36.7080959897,
/* 27	D#/Eb	*/ 38.8908729653,
/* 28	E	*/ 41.2034446141,
/* 29	F	*/ 43.6535289291,
/* 30	F#/Gb	*/ 46.2493028390,
/* 31	G	*/ 48.9994294977,
/* 32	G#/Ab	*/ 51.9130871975,
/* 33	A	*/ 55.0000000000,
/* 34	A#/Bb	*/ 58.2704701898,
/* 35	B	*/ 61.7354126570,
//octave -2
/* 36	C	*/ 65.4063913251,
/* 37	C#/Db	*/ 69.2956577442,
/* 38	D	*/ 73.4161919794,
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
/* 122	D	*/ 9397.2725733570,
/* 123	D#/Eb	*/ 9956.0634791066,
/* 124	E	*/ 10548.0818212118,
/* 125	F	*/ 11175.3034058561,
/* 126	F#/Gb	*/ 11839.8215267723,
/* 127	G	*/ 12543.8539514160,
};

float notefreq(midi_note_t note)
{
    if (note < 0) return 0;
    return _12edo[note];
}
#endif
