svofski/fannyadams/(commit log)

2015-12-20 before moving headphone amp to the left
    [audio.sch, audioout.sch, synth.kicad_pcb, synth.sch]
2015-12-21 drc ok large vias
    [audio.sch, audioout.sch, megapower.sch, synth.kicad_pcb]
2015-12-21 ok
    adding inline resistors on i2s next
    [synth.kicad_pcb]
2015-12-21 battery is on the wrong side... sigh
    [audioout.sch, synth.kicad_pcb, synth.sch]
2015-12-22 version sent to rezonit
    modified usb connector pads to smd
    [audio.sch, audioout.sch, megapower.sch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]
2015-12-28 fixed p-mosfets
    [audio.sch, audioout.sch, synth.kicad_pcb, synth.sch]
2015-12-29 fixed prototypes
2015-12-30 tim1 complementary pwm + rudimentary duty cycle adjustment using dead-time
2016-01-03 power management works, dc-dc needs tuning
2016-01-05 circuit fixes
    [_saved_audioout.sch, megapower.sch, synth.kicad_pcb]
2016-01-23 the shit is fucked basically, although implicit feedback works well on OSX. windows cares buggerall about implicit feedback
    [i2s.c, i2s.h, power.c, usbcmp.c, usrat.c, xprintf.c]
2020-01-05 CDC + Audio enumerates under windows
    * removed libopencm3 as submodule: ref usbaudio branch in my repo
    * experimental tweaks with volume
    * implemented mute control by zeroing out samples
    * cdc only does distorted echo
    * not sure but debug uart doesn't seem to be working, could be a faulty
    usb serial dongle
    [fannyadams.c, i2s.c, usbcmp.c, usbcmp_descriptors.c, usbcmp_descriptors.h, usrat.c]
2020-01-25 enumerates fine but doesn't wrok
    [usbcmp.c, usbcmp_ac.c, usbcmp_descriptors.c, usbcmp_descriptors.h, usbmidi.c]
2020-01-26 read from the correct endpoint ~\_('/' )_/~
    [usbmidi.c]
2020-01-26 some midi messages parsing
    note on,note off, pitch bend, cc/sound off
2020-01-30 audio + midi works
    audible aliasing on the sine wave, maybe 256 samples is not enough
2020-01-30 multiple oscillators experiment
    apparently 16 oscillators is already a problem. hmm?
    [sintab.h, sintab.py, synth.c, usbcmp.c]
2020-02-04 plays midi file
    * all with a single adsr
    * all with the same sin oscillator
    * all with the same volume
    * floats seem to work well on M4 so it's all float
    * initial 1s delay hacked in -- not sure what's going on there but
    while enumerating it's better to stay clear of synthing -- posisbly
    performance problems or something else
    * other than that 16 channels no probs
    [adsr.c, adsr.h, fannyadams.c, midi.h, notefreq.c, sintab.h, sintab.py]
2020-02-04 support midi velocity->volume and panic commands
2020-02-05 jacks can be replugged multiple times
    cm_disable_interrupts() appears to kill the main loop somehow.
    there is no real need to disable interrupts there, so there.
2020-02-07 implemented triangle, saw, pwm
2020-02-13 implemented program change and some lame patches
    * fixed pitchbend
    * patches are just foolery with adsr and waveforms
    [midi.c, midi.h, notefreq.c, osc.c, osc.h, patch.c, patch.h]
2020-02-14 linux emulator wrapped in alsa
    allows developing the synth engine on a pc without stm32 board
    running the emulator creates a midi synth device in linux
    connect vmpk:
    aconnect 129:0 128:0
    play a midi:
    pmidi -p 128:0 yehat.mid
